Austin-Hunter1/HunterClock/README.md

# HunterClock

The Weasley Clock: a grandfather clock whose six hands show how far each person is from home.

Site: https://austin-hunter1.github.io/HunterClock/ (design notes PDF, 3D model, hardware plan, circuit diagram, order checklist)
