Austin-Hunter1/HunterClock/docs/img/weasley_clock_face_and_screens.png

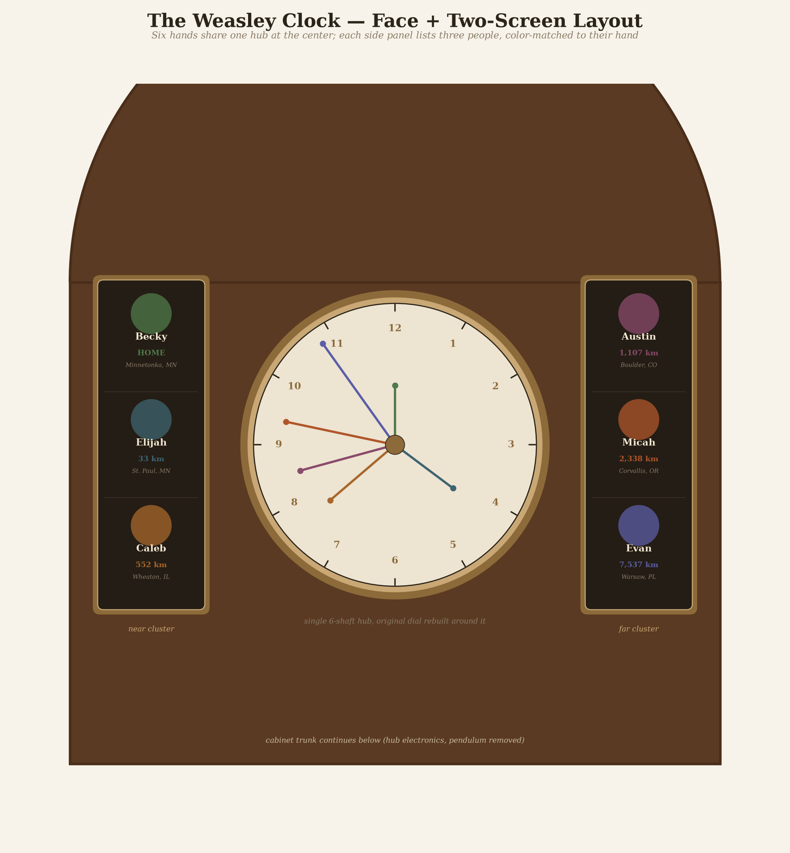
docs/img/weasley_clock_face_and_screens.png
