Austin-Hunter1/HunterClock/weasley_clock_displays.png

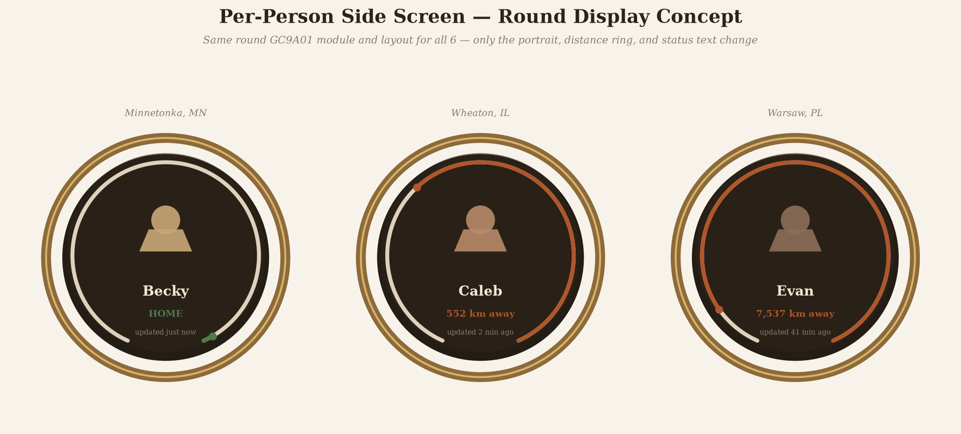
weasley_clock_displays.png
