Austin-Hunter1/HunterClock/motors/23HS18-2004H.STEP

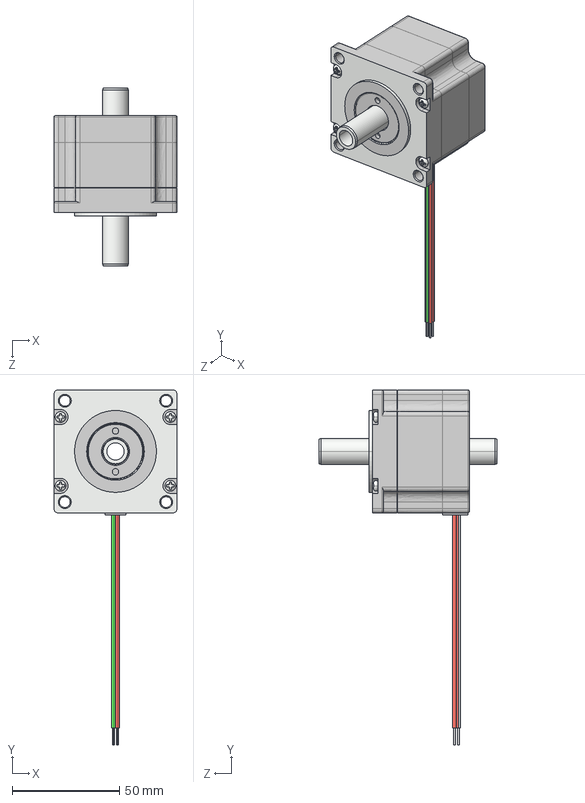
[picture p8: CAD file, 2026-10-06]
motors/23HS18-2004H.STEP
57.2 x 165.2 x 83.0 mm
