Austin-Hunter1/HunterClock/motors/17HS13-1504H.STEP

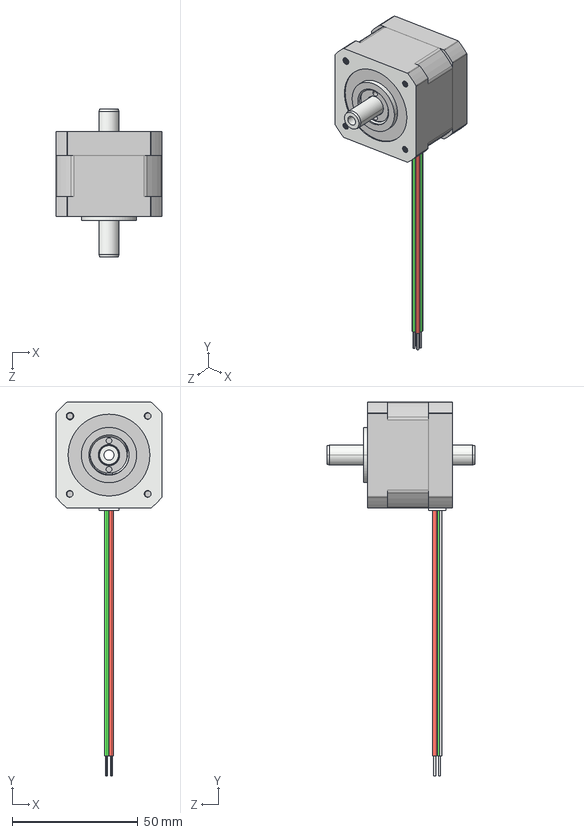
[picture p9: CAD file, 2026-10-06]
motors/17HS13-1504H.STEP
42.2 x 148.7 x 58.8 mm
