Austin-Hunter1/HunterClock/(commit log)

2026-10-05 Add CadQuery model and CAD build workflow
2026-10-06 In-line motor stack using 17HS13 STEP; add round screen locations
    [17HS13-1504H.STEP]
2026-10-06 Rework CAD: 360-deg mapping, NEMA23+NEMA17 column drive, side screen panels, case outline
2026-10-06 Add 23HS18-2004H motor STEP
    [23HS18-2004H.STEP]
2026-10-06 Export colored GLB and coarser STL
2026-10-06 Update design PDF: inspiration, distance-vs-angle figure, hollow-shaft stack, to-do list
2026-10-06 Rebuild CAD as coaxial hollow-shaft motor stack
2026-10-06 Lighten motor color; update viewer presets
2026-10-06 Hollow-shaft stack in viewer and PDF; lighter motors; tidy layout
